purduehackers/beacons/kicad/beacons.kicad_pcb

## KiCad design kicad/beacons.kicad_pcb (2025-09-06)

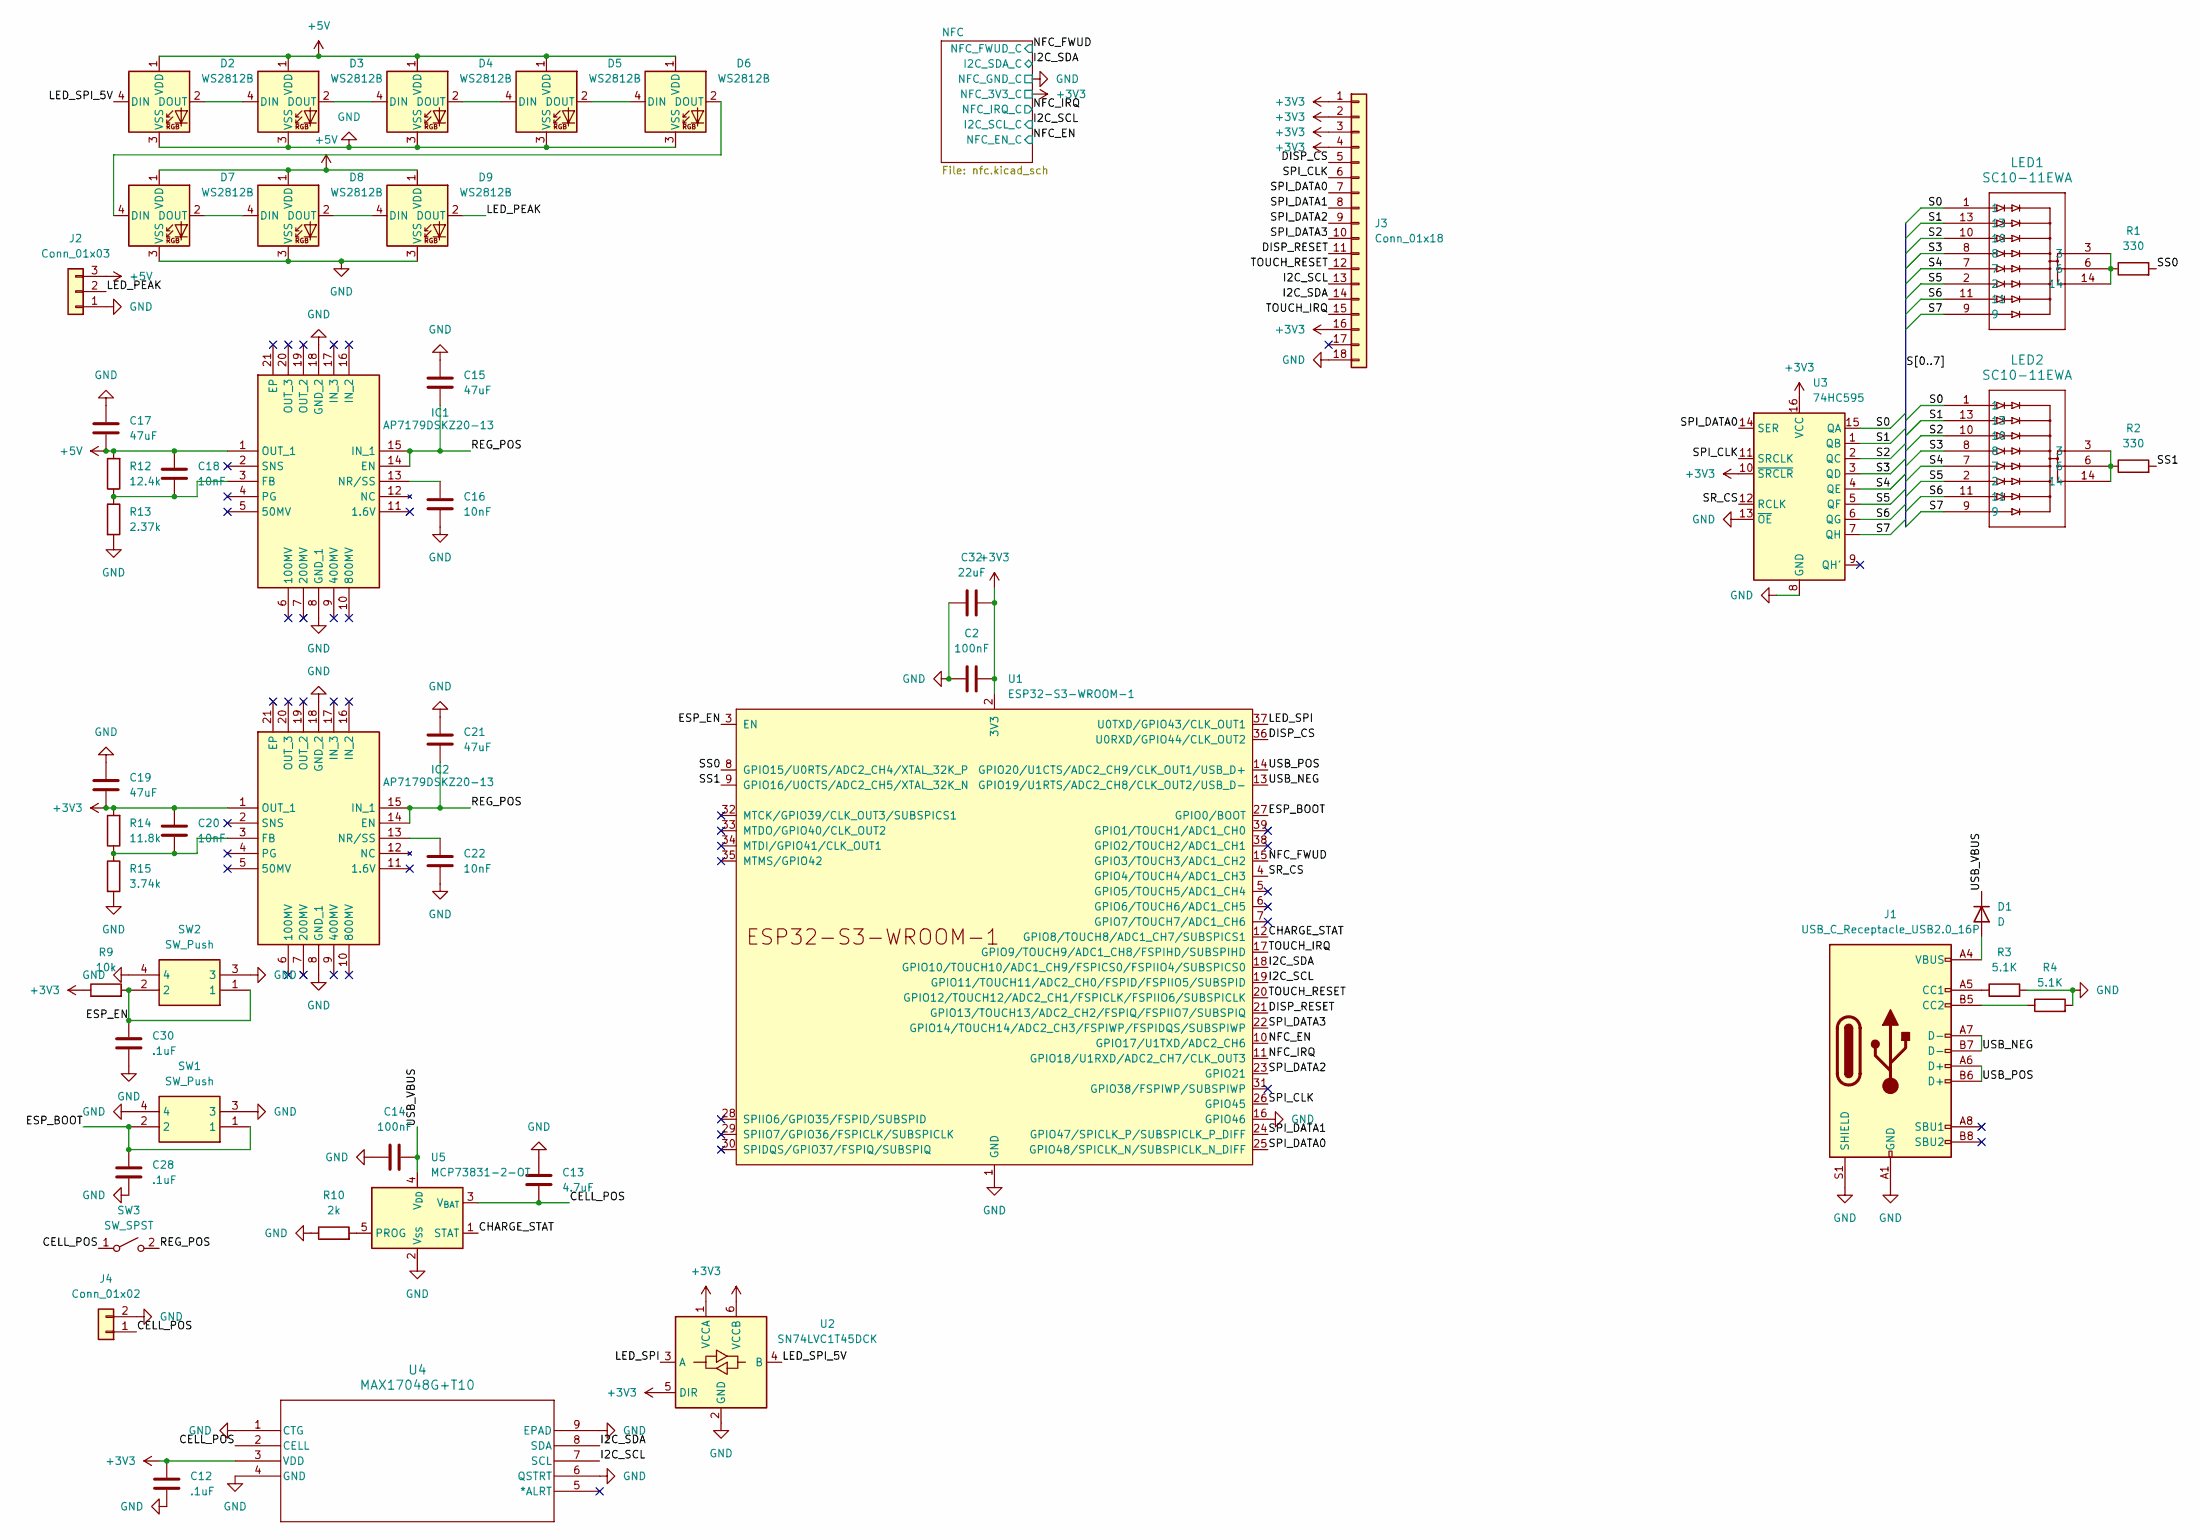
[picture p1: schematic beacons.kicad_sch]

Parts:
C2, C14: 100nF; C_0402_1005Metric
C12, C28, C30: .1uF; C_0402_1005Metric
C13: 4.7uF; C_0402_1005Metric
C15, C17, C19, C21: 47uF; C_0402_1005Metric
C16, C18, C20, C22: 10nF; C_0402_1005Metric
C32: 22uF; C_0402_1005Metric
D1: D; D_SOD-323
D2, D3, D4, D5, D6, D7, D8, D9: WS2812B; LED_WS2812B_PLCC4_5.0x5.0mm_P3.2mm
IC1, IC2: AP7179DSKZ20-13; QFN50P350X350X80-21N-D; Manufacturer_Part_Number AP7179DSKZ20-13
J1: USB_C_Receptacle_USB2.0_16P; USB_C_Receptacle_GCT_USB4105-xx-A_16P_TopMnt_Horizontal
J2: Conn_01x03; JST_PH_B3B-PH-K_1x03_P2.00mm_Vertical
J3: Conn_01x18; DisplayConnector
J4: Conn_01x02; AMASS_XT30UPB-M_1x02_P5.0mm_Vertical
LED1, LED2: SC10-11EWA; SC10-11EWA_KNB
R1, R2: 330; R_0402_1005Metric
R3, R4: 5.1K; R_0402_1005Metric
R9: 10k; R_0402_1005Metric
R10: 2k; R_0402_1005Metric
R12: 12.4k; R_0402_1005Metric
R13: 2.37k; R_0402_1005Metric
R14: 11.8k; R_0402_1005Metric
R15: 3.74k; R_0402_1005Metric
SW1, SW2: SW_Push; SMT_4.2X3.2_; Manufacturer_Part_Number SKRPACE010; Mouser Part Number 688-SKRPACE010
SW3: SW_SPST; AMASS_XT30UPB-M_1x02_P5.0mm_Vertical
U1: ESP32-S3-WROOM-1
U2: SN74LVC1T45DCK; SOT-363_SC-70-6
U3: 74HC595; SSOP-16_5.3x6.2mm_P0.65mm
U4: MAX17048G+T10; 21-0168E_T822-3_MXM
U5: MCP73831-2-OT; SOT-23-5

Connections:
+3V3: C2.2, C12.1, C19.2, C20.1, C32.2, IC2.1 (OUT_1), J3.1, J3.2, J3.3, J3.4, J3.16, R9.1, R14.2, U1.2 (3V3), U2.1 (VCCA), U2.5 (DIR), U3.10 (~SRCLR), U3.16 (VCC), U4.3 (VDD); also elsewhere on the board
+5V: C17.2, C18.1, D2.1 (VDD), D3.1 (VDD), D4.1 (VDD), D5.1 (VDD), D6.1 (VDD), D7.1 (VDD), D8.1 (VDD), D9.1 (VDD), IC1.1 (OUT_1), J2.3, R12.2, U2.6 (VCCB)
/CELL_POS: C13.2, J4.1, SW3.1 (A), U4.2 (CELL), U5.3 (V_{BAT})
/CHARGE_STAT: U1.12 (GPIO8/TOUCH8/ADC1_CH7/SUBSPICS1), U5.1 (STAT)
/DISP_CS: J3.5, U1.36 (U0RXD/GPIO44/CLK_OUT2)
/DISP_RESET: J3.11, U1.21 (GPIO13/TOUCH13/ADC2_CH2/FSPIQ/FSPIIO7/S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)
/ESP_BOOT: C28.1, SW1.1, SW1.2, U1.27 (GPIO0/BOOT)
/ESP_EN: C30.1, R9.2, SW2.1, SW2.2, U1.3 (EN)
/I2C_SCL: J3.13, U1.19 (GPIO11/TOUCH11/ADC2_CH0/FSPID/FSPIIO5/S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), U4.7 (SCL); also elsewhere on the board
/I2C_SDA: J3.14, U1.18 (GPIO10/TOUCH10/ADC1_CH9/FSPICS0/FSPIIO4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), U4.8 (SDA); also elsewhere on the board
/LED_PEAK: D9.2 (DOUT), J2.2
/LED_SPI: U1.37 (U0TXD/GPIO43/CLK_OUT1), U2.3 (A)
/LED_SPI_5V: D2.4 (DIN), U2.4 (B)
/NFC_EN: U1.10 (GPIO17/U1TXD/ADC2_CH6); also elsewhere on the board
/NFC_FWUD: U1.15 (GPIO3/TOUCH3/ADC1_CH2); also elsewhere on the board
/NFC_IRQ: U1.11 (GPIO18/U1RXD/ADC2_CH7/CLK_OUT3); also elsewhere on the board
/REG_POS: C15.2, C21.2, IC1.14 (EN), IC1.15 (IN_1), IC2.14 (EN), IC2.15 (IN_1), SW3.2 (B)
/S0: LED1.1, LED2.1, U3.15 (QA)
/S1: LED1.13, LED2.13, U3.1 (QB)
/S2: LED1.10, LED2.10, U3.2 (QC)
/S3: LED1.8, LED2.8, U3.3 (QD)
/S4: LED1.7, LED2.7, U3.4 (QE)
/S5: LED1.2, LED2.2, U3.5 (QF)
/S6: LED1.11, LED2.11, U3.6 (QG)
/S7: LED1.9, LED2.9, U3.7 (QH)
/SPI_CLK: J3.6, U1.26 (GPIO45), U3.11 (SRCLK)
/SPI_DATA0: J3.7, U1.25 (GPIO48/SPICLK_N/SUBSPICLK_N_DIFF), U3.14 (SER)
/SPI_DATA1: J3.8, U1.24 (GPIO47/SPICLK_P/SUBSPICLK_P_DIFF)
/SPI_DATA2: J3.9, U1.23 (GPIO21)
/SPI_DATA3: J3.10, U1.22 (GPIO14/TOUCH14/ADC2_CH3/FSPIWP/FSPIDQS/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)
/SR_CS: U1.4 (GPIO4/TOUCH4/ADC1_CH3), U3.12 (RCLK)
/SS0: R1.2, U1.8 (GPIO15/U0RTS/ADC2_CH4/XTAL_32K_P)
/SS1: R2.2, U1.9 (GPIO16/U0CTS/ADC2_CH5/XTAL_32K_N)
/TOUCH_IRQ: J3.15, U1.17 (GPIO9/TOUCH9/ADC1_CH8/FSPIHD/SUBSPIHD)
/TOUCH_RESET: J3.12, U1.20 (GPIO12/TOUCH12/ADC2_CH1/FSPICLK/FSPIIO6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)
/USB_NEG: J1.A7 (D-), J1.B7 (D-), U1.13 (GPIO19/U1RTS/ADC2_CH8/CLK_OUT2/USB_D-)
/USB_POS: J1.A6 (D+), J1.B6 (D+), U1.14 (GPIO20/U1CTS/ADC2_CH9/CLK_OUT1/USB_D+)
/USB_VBUS: C14.2, D1.1 (K), U5.4 (V_{DD})
GND: C2.1, C12.2, C13.1, C14.1, C15.1, C16.1, C17.1, C19.1, C21.1, C22.1, C28.2, C30.2, C32.1, D2.3 (VSS), D3.3 (VSS), D4.3 (VSS), D5.3 (VSS), D6.3 (VSS), D7.3 (VSS), D8.3 (VSS), D9.3 (VSS), IC1.8 (GND_1), IC1.18 (GND_2), IC2.8 (GND_1), IC2.18 (GND_2), J1.A1 (GND), J1.A12 (GND), J1.B1 (GND), J1.B12 (GND), J1.S1 (SHIELD), J2.1, J3.18, J4.2, R3.2, R4.2, R10.1, R13.2, R15.2, SW1.3, SW1.4, SW2.3, SW2.4, U1.1 (GND), U1.16 (GPIO46), U1.40 (GND), U1.41 (GND), U2.2 (GND), U3.8 (GND), U3.13 (~OE), U4.1 (CTG), U4.4 (GND), U4.6 (QSTRT), U4.9 (EPAD), U5.2 (V_{SS}); also elsewhere on the board
unnamed: D1.2 (A), J1.A4 (VBUS), J1.A9 (VBUS), J1.B4 (VBUS), J1.B9 (VBUS)
unnamed: D2.2 (DOUT), D3.4 (DIN)
unnamed: D3.2 (DOUT), D4.4 (DIN)
unnamed: D4.2 (DOUT), D5.4 (DIN)
unnamed: D5.2 (DOUT), D6.4 (DIN)
unnamed: D6.2 (DOUT), D7.4 (DIN)
unnamed: D7.2 (DOUT), D8.4 (DIN)
unnamed: D8.2 (DOUT), D9.4 (DIN)
unnamed: C18.2, IC1.3 (FB), R12.1, R13.1
unnamed: C16.2, IC1.13 (NR/SS)
unnamed: C20.2, IC2.3 (FB), R14.1, R15.1
unnamed: C22.2, IC2.13 (NR/SS)
unnamed: J1.A5 (CC1), R3.1
unnamed: J1.B5 (CC2), R4.1
unnamed: LED1.3, LED1.6, LED1.14, R1.1
unnamed: LED2.3, LED2.6, LED2.14, R2.1
unnamed: R10.2, U5.5 (PROG)

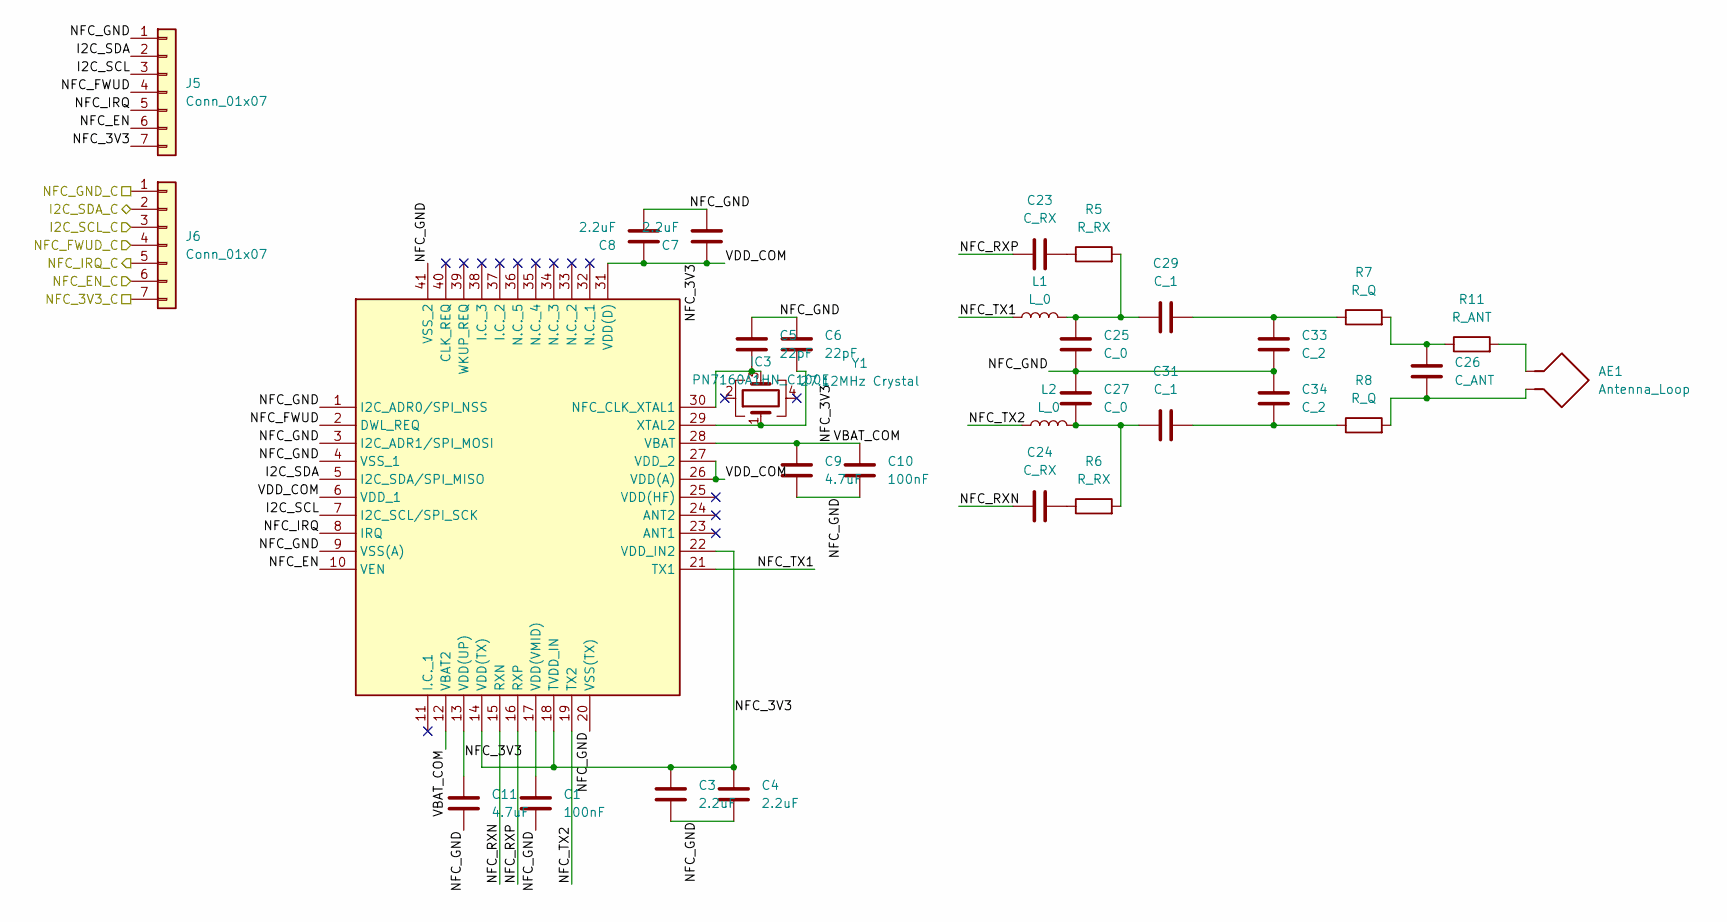
[picture p2: schematic nfc.kicad_sch, NFC Components]

Parts:
AE1: Antenna_Loop; NFC
C1, C10: 100nF; C_0402_1005Metric
C3, C4, C7, C8: 2.2uF; C_0402_1005Metric
C5, C6: 22pF; C_0402_1005Metric
C9, C11: 4.7uF; C_0402_1005Metric
C23, C24: C_RX; C_0402_1005Metric
C25, C27: C_0; C_0402_1005Metric
C26: C_ANT; C_0402_1005Metric
C29, C31: C_1; C_0402_1005Metric
C33, C34: C_2; C_0402_1005Metric
IC3: PN7160A1HN_C100E; QFN50P600X600X100-41N-D; Manufacturer_Part_Number PN7160A1HN/C100E; Mouser Part Number 771-PN7160A1HN/C100E
J5, J6: Conn_01x07; JST_PH_B7B-PH-K_1x07_P2.00mm_Vertical
L1, L2: L_0; L_0402_1005Metric
R5, R6: R_RX; R_0402_1005Metric
R7, R8: R_Q; R_0402_1005Metric
R11: R_ANT; R_0402_1005Metric
Y1: 27.12MHz Crystal; Crystal_SMD_2016-4Pin_2.0x1.6mm

Connections:
+3V3: J6.7; also elsewhere on the board
/I2C_SCL: J6.3; also elsewhere on the board
/I2C_SDA: J6.2; also elsewhere on the board
/NFC/I2C_SCL: IC3.7 (I2C_SCL/SPI_SCK), J5.3
/NFC/I2C_SDA: IC3.5 (I2C_SDA/SPI_MISO), J5.2
/NFC/NFC_EN: IC3.10 (VEN), J5.6
/NFC/NFC_FWUD: IC3.2 (DWL_REQ), J5.4
/NFC/NFC_GND: C1.2, C3.2, C4.2, C5.1, C6.1, C7.2, C8.2, C9.2, C10.2, C11.2, C25.2, C27.1, C33.2, C34.1, IC3.1 (I2C_ADR0/SPI_NSS), IC3.3 (I2C_ADR1/SPI_MOSI), IC3.4 (VSS_1), IC3.9 (VSS(A)), IC3.20 (VSS(TX)), IC3.41 (VSS_2), J5.1
/NFC/NFC_IRQ: IC3.8 (IRQ), J5.5
/NFC/NFC_RXN: C24.1, IC3.15 (RXN)
/NFC/NFC_RXP: C23.1, IC3.16 (RXP)
/NFC/NFC_TX1: IC3.21 (TX1), L1.1
/NFC/NFC_TX2: IC3.19 (TX2), L2.1
/NFC_EN: J6.6; also elsewhere on the board
/NFC_FWUD: J6.4; also elsewhere on the board
/NFC_IRQ: J6.5; also elsewhere on the board
GND: J6.1; also elsewhere on the board
unnamed: AE1.1, R11.2
unnamed: AE1.2, C26.2, R8.2
unnamed: C23.2, R5.1
unnamed: C24.2, R6.1
unnamed: C25.1, C29.1, L1.2, R5.2
unnamed: C26.1, R7.2, R11.1
unnamed: C27.2, C31.1, L2.2, R6.2
unnamed: C29.2, C33.1, R7.1
unnamed: C31.2, C34.2, R8.1
unnamed: C5.2, IC3.30 (NFC_CLK_XTAL1), Y1.3
unnamed: C1.1, IC3.17 (VDD(VMID))
unnamed: C6.2, IC3.29 (XTAL2), Y1.1

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
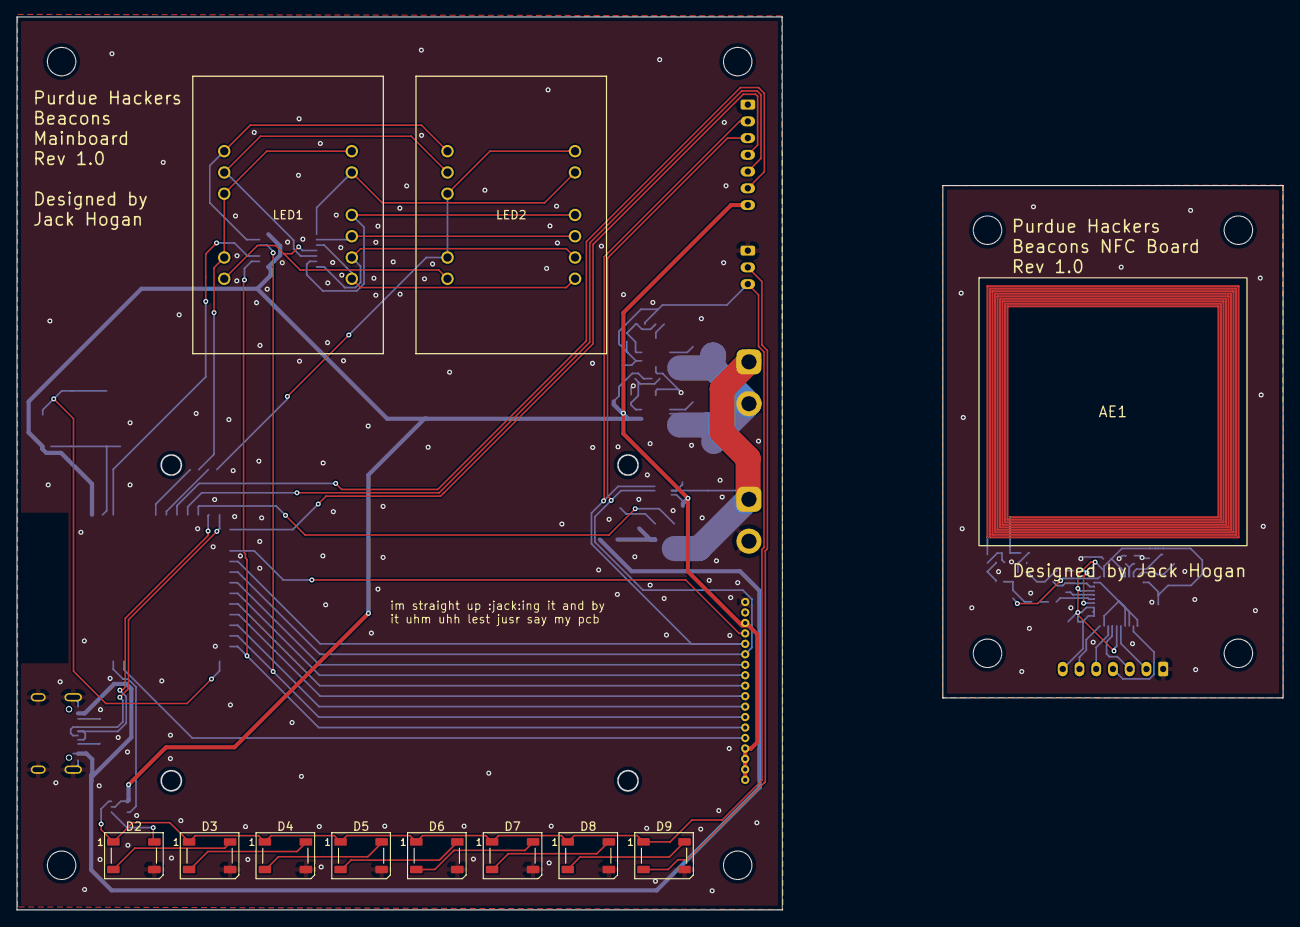
[picture p3: board beacons.kicad_pcb from above]

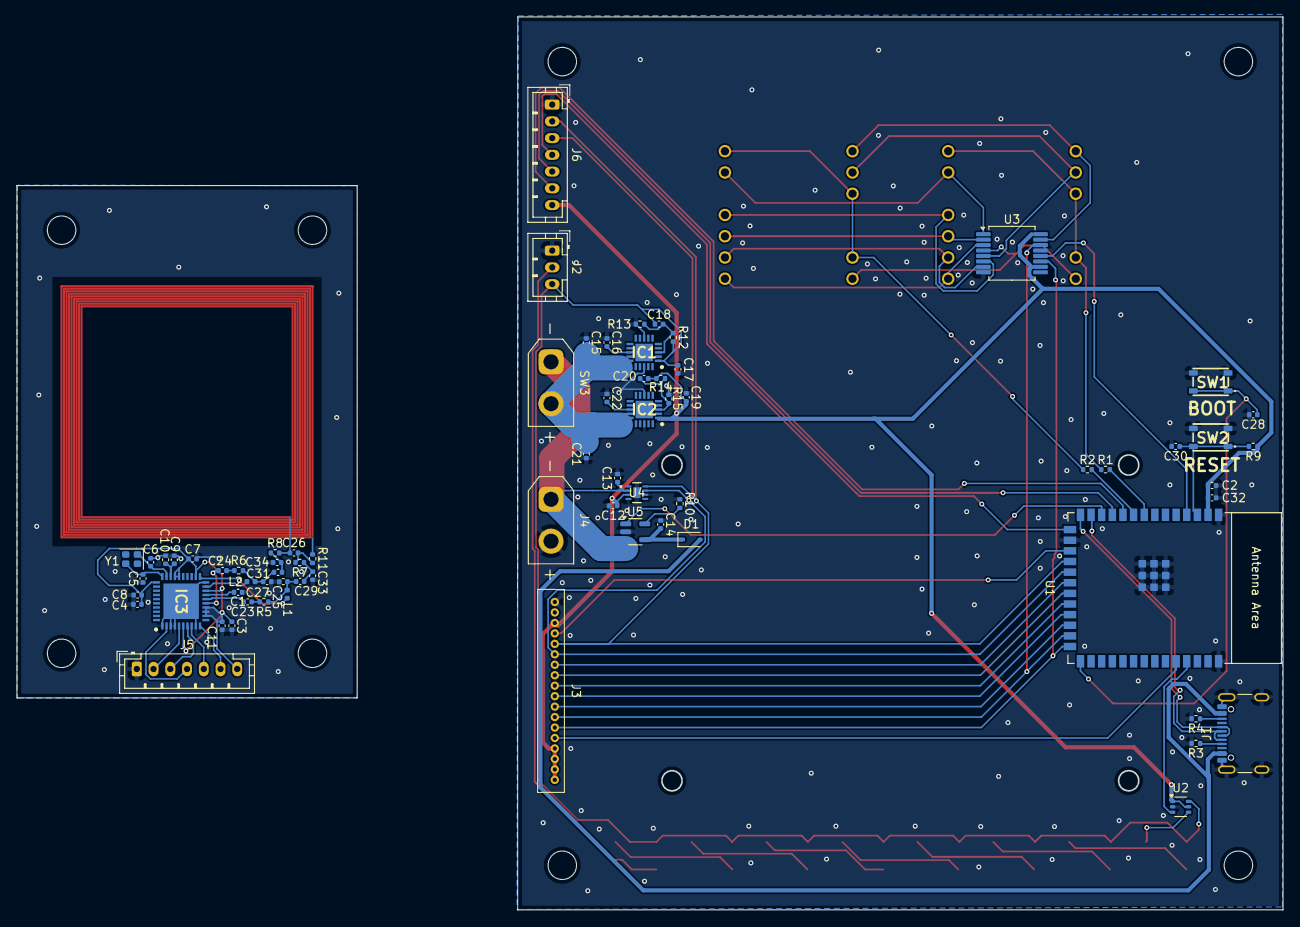
[picture p4: board beacons.kicad_pcb from below]

Board: 2 copper layers, 151.3 x 106.7 mm, 81 parts (70 on the bottom side), 80 nets.
