purduehackers/beacons/(commit log)

2025-01-04 LEDs and first flash
    [partitions.csv]
2025-07-25 Setup NFC and moved shift register to SPI
2025-07-25 Switch to I2C for NFC, hookup touch panel
2025-07-27 Start work on PCB
    [beacons.kicad_pcb, beacons.kicad_sch]
2025-07-27 More pcb work
    [beacons.kicad_pcb, beacons.kicad_sch]
2025-07-31 Tons of stuff
    [beacons.kicad_pcb, beacons.kicad_sch]
2025-08-02 Routing and RF
    [beacons.kicad_pcb, beacons.kicad_sch, nfc.kicad_sch]
2025-08-02 First revision
    [beacons.kicad_pcb, beacons.kicad_sch, nfc.kicad_sch]
2025-08-03 Added level shifter
    [beacons.kicad_pcb, beacons.kicad_sch, nfc.kicad_sch]
2025-08-03 Added NFC enable pin
    [beacons.kicad_pcb, beacons.kicad_sch, nfc.kicad_sch]
2025-09-02 Move nfc antenna away from traces
    [beacons.kicad_pcb]
2025-09-06 Start pcb review
    [beacons.kicad_pcb]
